grounded042/landerviz/hardware/carrier/shopping-digikey.csv

DigiKey Part Number | Quantity | Customer Reference
5032-333011-ND | 2 | J1 J2 USB-C breakout modules
102-1760-ND | 1 | SW3 12-detent encoder with push
CP1-3533NG-ND | 1 | J3 three-terminal audio jack
BAT85SCT-ND | 4 | D1 D2 D3 D4 audio clamps - cut tape
BC1050CT-ND | 2 | C3 C5 2.2nF C0G 5mm lead spacing - cut tape
754-1915-ND | 1 | D5 green status LED
SW400-ND | 2 | SW1 SW2 boot and reset - omit if already owned and matching
