grounded042/landerviz/hardware/carrier/landerviz-carrier.kicad_pcb

## KiCad design hardware/carrier/landerviz-carrier.kicad_pcb (2026-11-08)

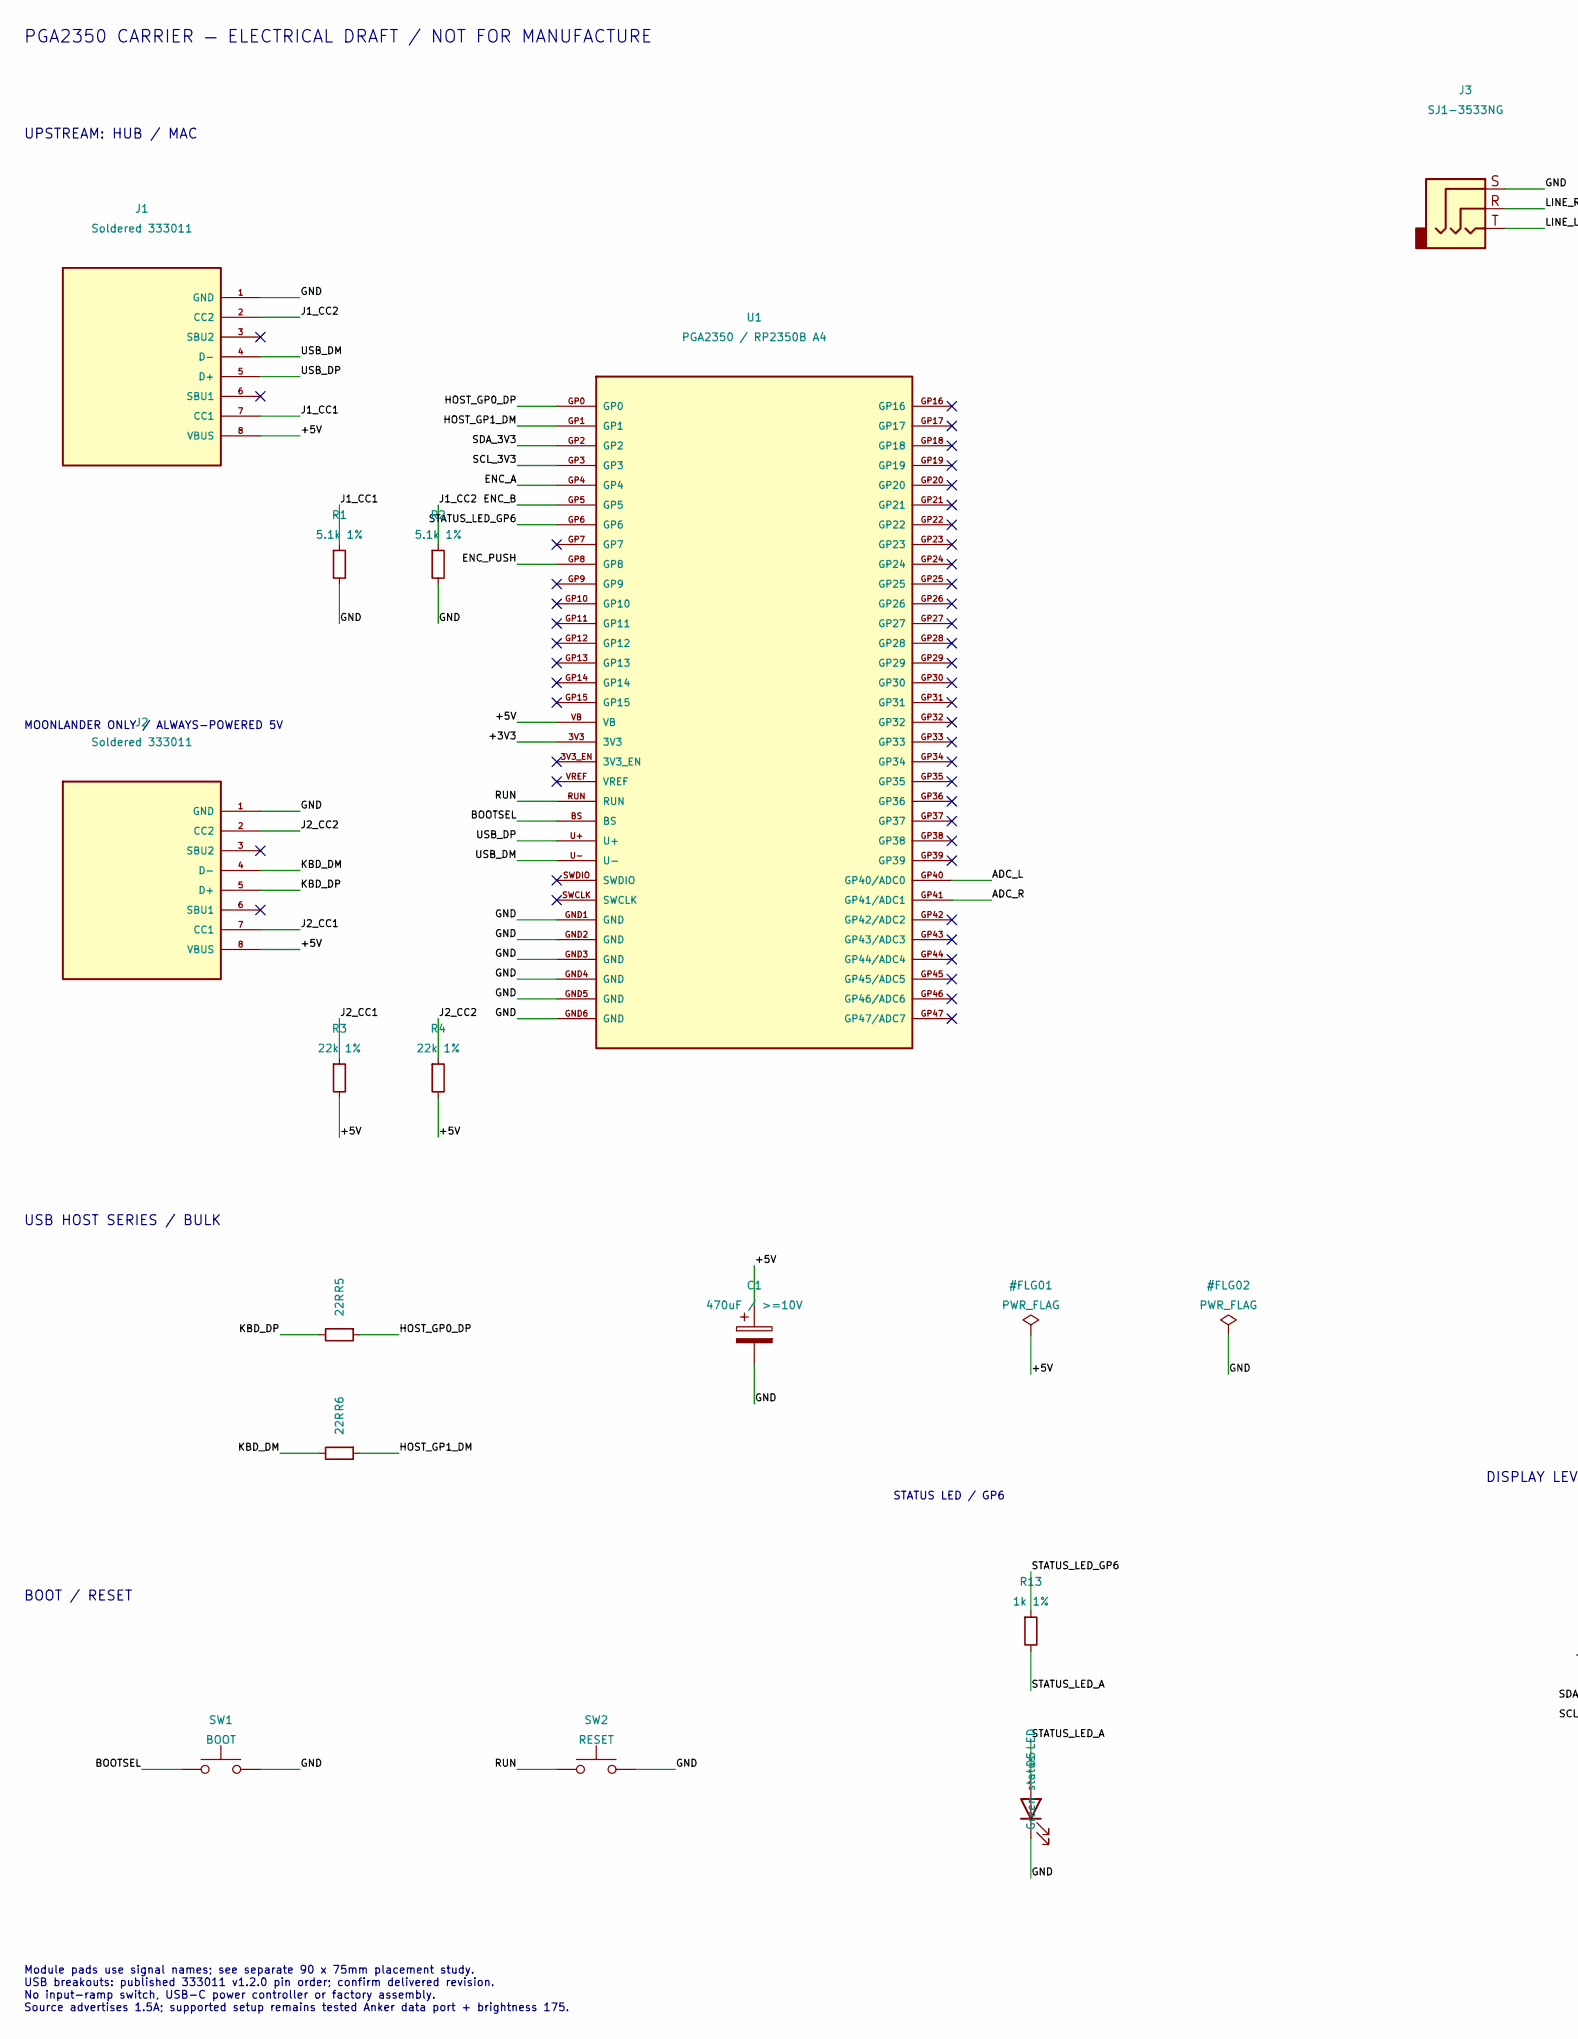
[picture p1: schematic landerviz-carrier.kicad_sch, LanderViz PGA2350 carrier — electrical draft, part in row 1, column 1]

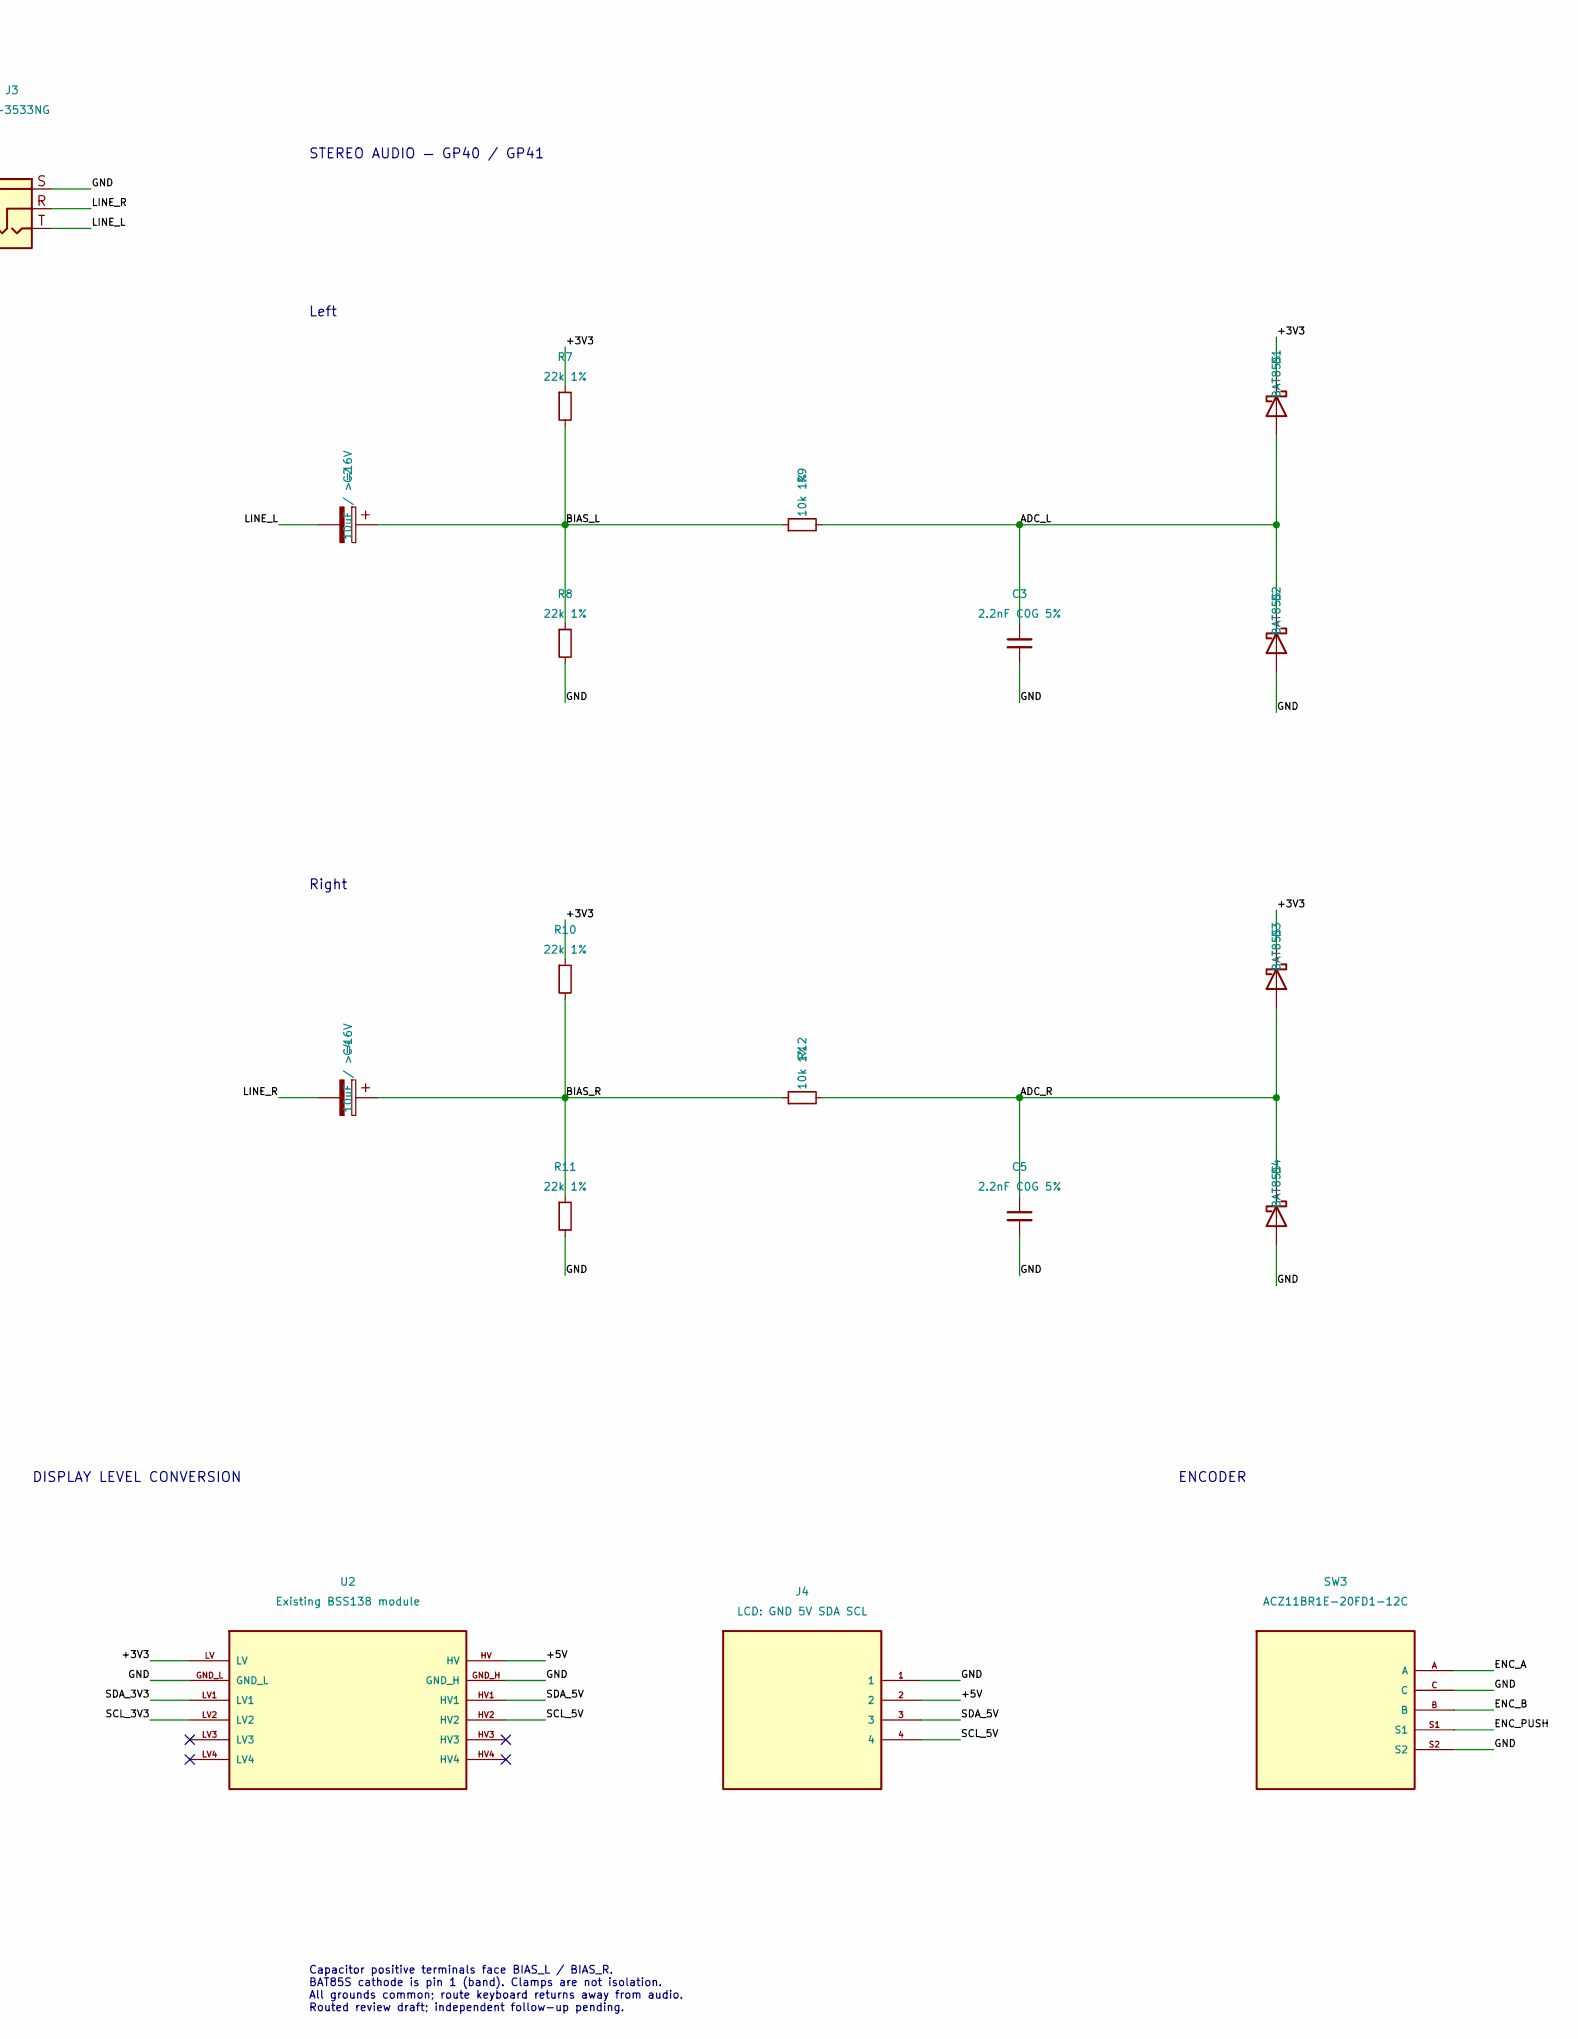
[picture p2: schematic landerviz-carrier.kicad_sch, LanderViz PGA2350 carrier — electrical draft, part in row 1, column 2]

Parts:
C1: 470uF / >=10V; CP_Radial_D8.0mm_P3.50mm
C2, C4: 10uF / >=16V; CP_Radial_D6.3mm_P2.50mm
C3, C5: 2.2nF C0G 5%; C_Disc_D5.0mm_W2.5mm_P5.00mm
D1, D2, D3, D4: BAT85S; D_DO-35_SOD27_P7.62mm_Horizontal; MPN BAT85S-TR
D5: Green status LED; LED_D3.0mm; MPN WP710A10LZGCK
J1, J2: Soldered 333011; Soldered_333011; MPN 333011
J3: SJ1-3533NG; Jack_3.5mm_CUI_SJ1-3533NG_Horizontal_CircularHoles; MPN SJ1-3533NG
J4: LCD: GND 5V SDA SCL; PinHeader_1x04_P2.54mm_Vertical
R1, R2: 5.1k 1%; R_Axial_DIN0207_L6.3mm_D2.5mm_P7.62mm_Horizontal
R3, R4, R7, R8, R10, R11: 22k 1%; R_Axial_DIN0207_L6.3mm_D2.5mm_P7.62mm_Horizontal
R5, R6: 22R; R_Axial_DIN0207_L6.3mm_D2.5mm_P7.62mm_Horizontal
R9, R12: 10k 1%; R_Axial_DIN0207_L6.3mm_D2.5mm_P7.62mm_Horizontal
R13: 1k 1%; R_Axial_DIN0207_L6.3mm_D2.5mm_P7.62mm_Horizontal
SW1: BOOT; SW_PUSH_6mm
SW2: RESET; SW_PUSH_6mm
SW3: ACZ11BR1E-20FD1-12C; Encoder_SameSky_ACZ11BR1E_Vertical; MPN ACZ11BR1E-20FD1-12C
U1: PGA2350 / RP2350B A4; PGA2350_Socket_Grid; MPN PIM722
U2: Existing BSS138 module; Level_Converter_PROVISIONAL

Connections:
/+3V3: D1.1 (K), D3.1 (K), R7.1, R10.1, U1.3V3, U2.LV
/+5V: C1.1, J1.8 (VBUS), J2.8 (VBUS), J4.2, R3.2, R4.2, U1.VB, U2.HV
/ADC_L: C3.1, D1.2 (A), D2.1 (K), R9.2, U1.GP40 (GP40/ADC0)
/ADC_R: C5.1, D3.2 (A), D4.1 (K), R12.2, U1.GP41 (GP41/ADC1)
/BIAS_L: C2.1, R7.2, R8.1, R9.1
/BIAS_R: C4.1, R10.2, R11.1, R12.1
/BOOTSEL: SW1.1, U1.BS
/ENC_A: SW3.A, U1.GP4
/ENC_B: SW3.B, U1.GP5
/ENC_PUSH: SW3.S1, U1.GP8
/GND: C1.2, C3.2, C5.2, D2.2 (A), D4.2 (A), D5.1 (K), J1.1 (GND), J2.1 (GND), J3.S, J4.1, R1.2, R2.2, R8.2, R11.2, SW1.2, SW2.2, SW3.C, SW3.S2, U1.GND1 (GND), U1.GND2 (GND), U1.GND3 (GND), U1.GND4 (GND), U1.GND5 (GND), U1.GND6 (GND), U2.GND_H, U2.GND_L
/HOST_GP0_DP: R5.1, U1.GP0
/HOST_GP1_DM: R6.1, U1.GP1
/J1_CC1: J1.7 (CC1), R1.1
/J1_CC2: J1.2 (CC2), R2.1
/J2_CC1: J2.7 (CC1), R3.1
/J2_CC2: J2.2 (CC2), R4.1
/KBD_DM: J2.4 (D-), R6.2
/KBD_DP: J2.5 (D+), R5.2
/LINE_L: C2.2, J3.T
/LINE_R: C4.2, J3.R
/RUN: SW2.1, U1.RUN
/SCL_3V3: U1.GP3, U2.LV2
/SCL_5V: J4.4, U2.HV2
/SDA_3V3: U1.GP2, U2.LV1
/SDA_5V: J4.3, U2.HV1
/STATUS_LED_A: D5.2 (A), R13.2
/STATUS_LED_GP6: R13.1, U1.GP6
/USB_DM: J1.4 (D-), U1.U-
/USB_DP: J1.5 (D+), U1.U+

Notes on the sheet:
PGA2350 CARRIER — ELECTRICAL DRAFT / NOT FOR MANUFACTURE
UPSTREAM: HUB / MAC
MOONLANDER ONLY / ALWAYS-POWERED 5V
STEREO AUDIO — GP40 / GP41
Left
Right
USB HOST SERIES / BULK
BOOT / RESET
DISPLAY LEVEL CONVERSION
ENCODER
STATUS LED / GP6
Module pads use signal names; see separate 90 x 75mm placement study. USB breakouts: published 333011 v1.2.0 pin order; confirm delivered revision. No input-ramp switch, USB-C power controller or factory assembly. Source advertises 1.5A; supported setup remains tested Anker data port + brightness 1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
Capacitor positive terminals face BIAS_L / BIAS_R. BAT85S cathode is pin 1 (band). Clamps are not isolation. All grounds common; route keyboard returns away from audio. Routed review draft; independent follow-up pending.

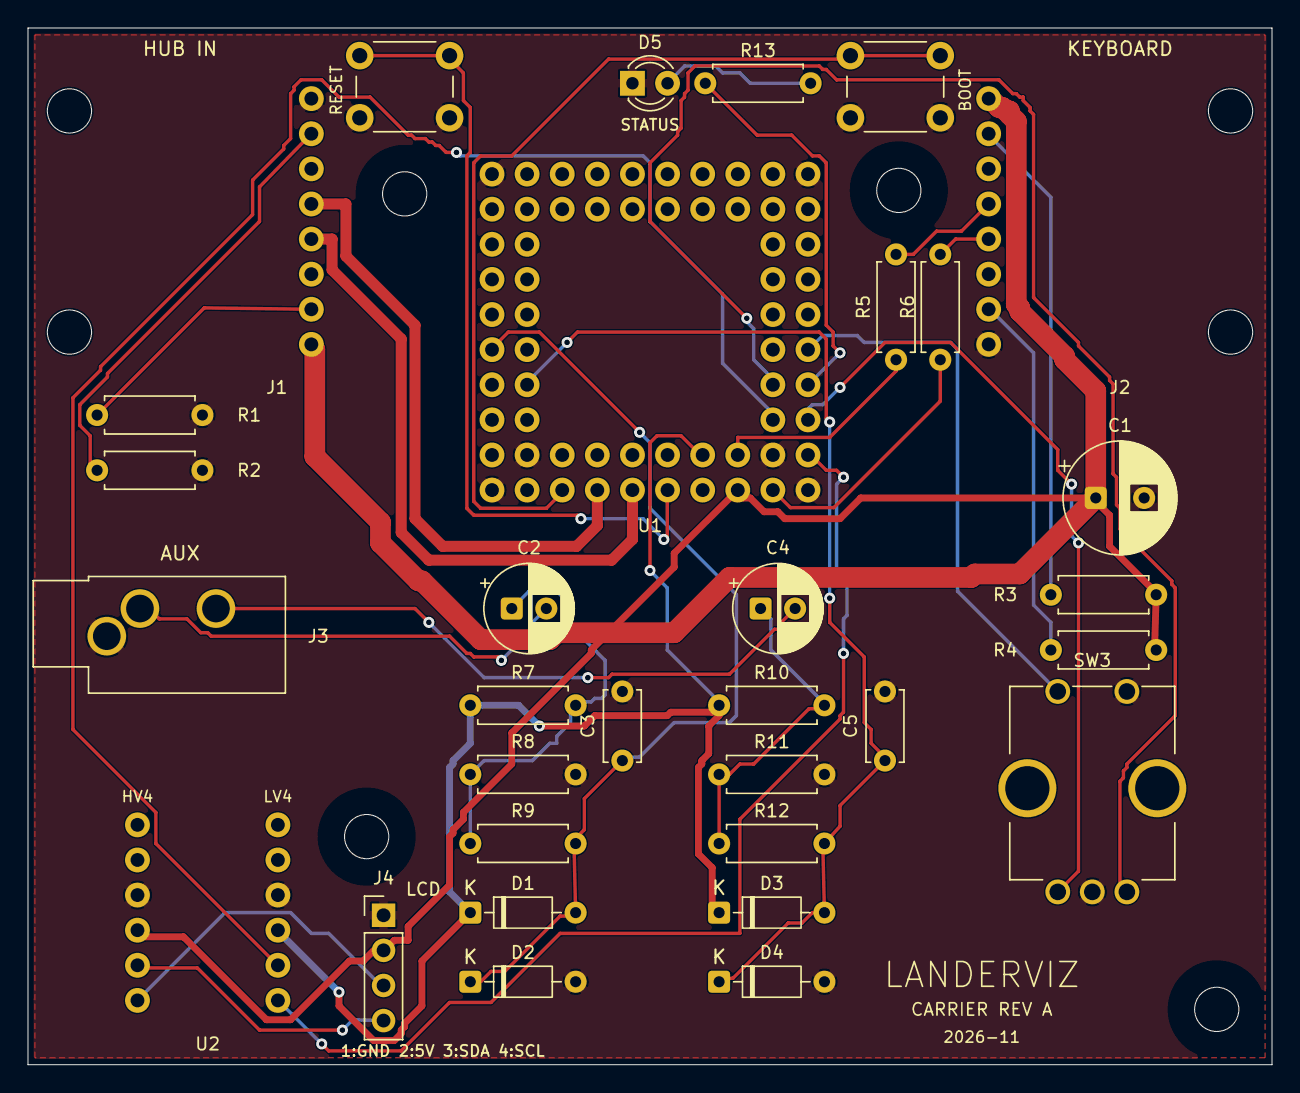
[picture p3: board landerviz-carrier.kicad_pcb from above]

Board: 2 copper layers, 90.0 x 75.0 mm, 36 parts (0 on the bottom side), 30 nets.

Other parts of the board:
H1, H2, H3, H4: M3 / max OD 7mm; MountingHole_3.2mm_M3_7mmHardware
