grounded042/landerviz/hardware/landerviz.kicad_pcb

## KiCad design hardware/landerviz.kicad_pcb (2026-11-07)

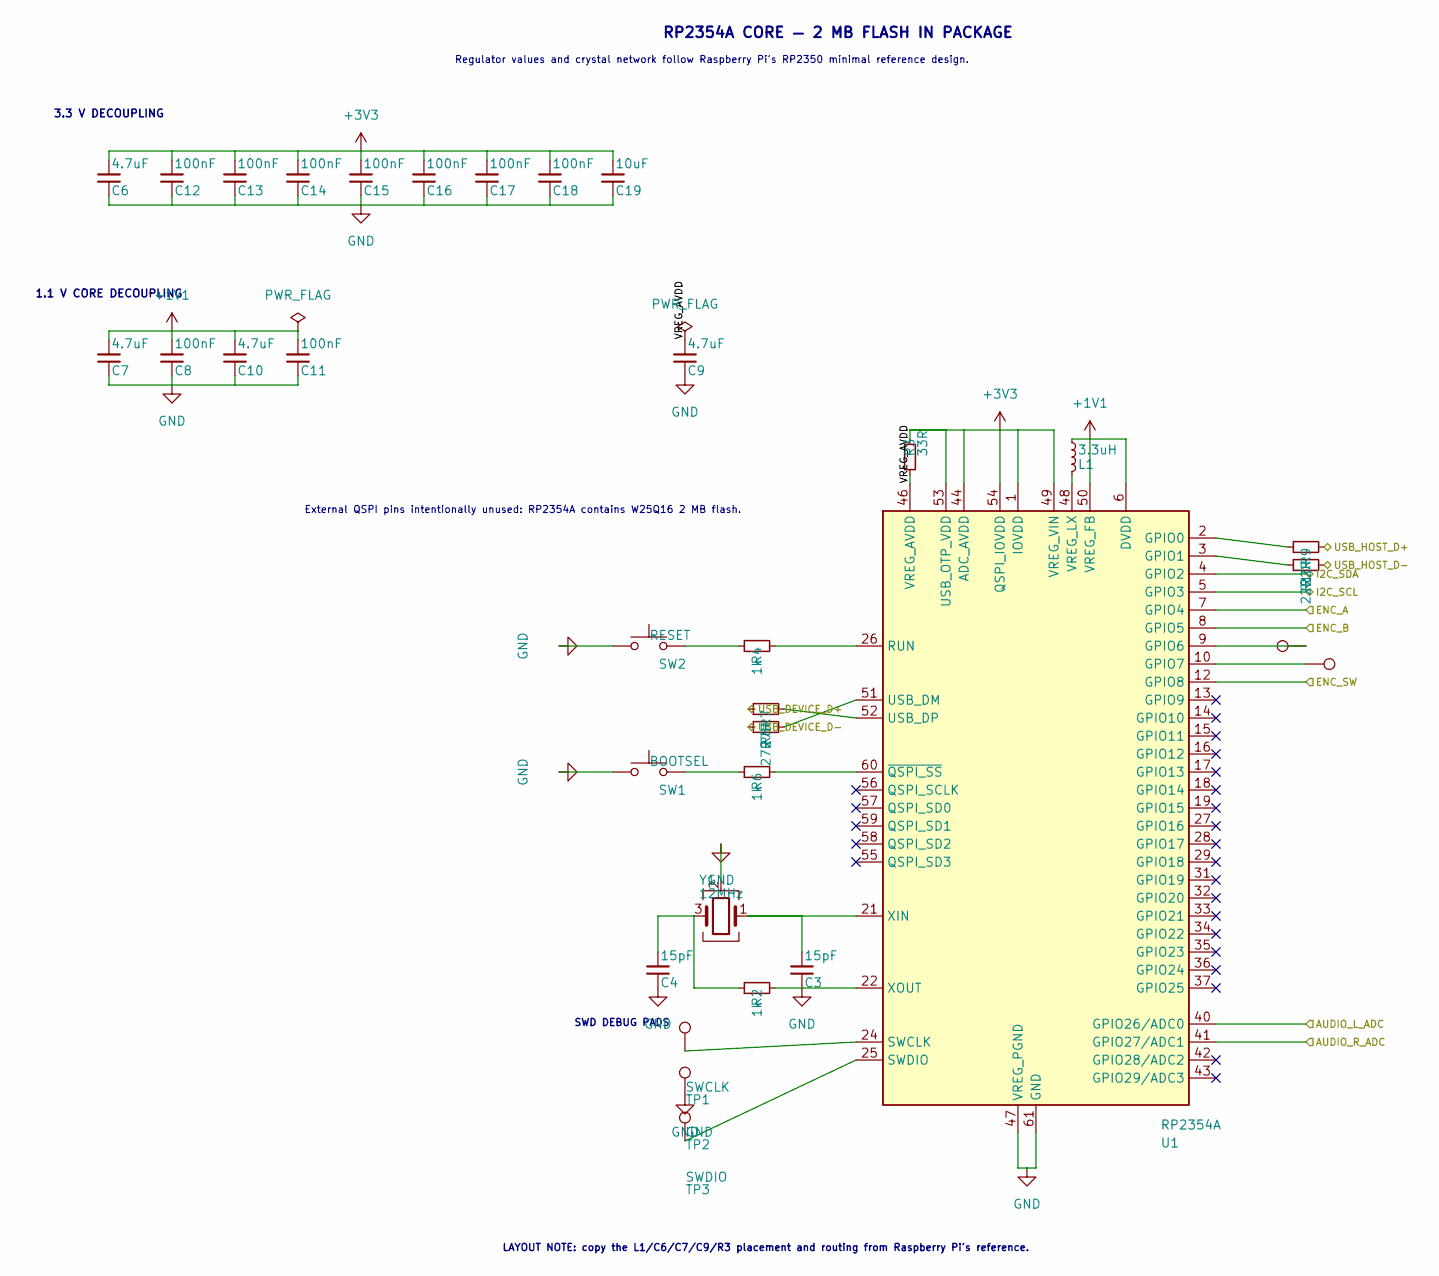
[picture p4: schematic mcu.kicad_sch]

Parts:
C3, C4: 15pF; C_0402_1005Metric; MPN 0402CG150J500NT; LCSC C1548
C6, C7, C9, C10: 4.7uF; C_0402_1005Metric; MPN GRM155R60J475ME47D; LCSC C82453
C8, C11, C12, C13, C14, C15, C16, C17, C18: 100nF; C_0402_1005Metric; MPN CL05B104KO5NNNC; LCSC C1525
C19: 10uF; C_0402_1005Metric; MPN TCC0402X5R106M6R3ATR; LCSC C48543727
L1: 3.3uH; L_Abracon_AOTA-B201610S3R3-101-T; MPN AOTA-B201610S3R3-101-T; LCSC C42411119
R2, R4, R6: 1k; R_0402_1005Metric; MPN 0402WGF1001TCE; LCSC C11702
R3: 33R; R_0402_1005Metric; MPN 0402WGF330JTCE; LCSC C25105
R7, R8: 27R; R_0402_1005Metric; MPN 0402WGF270JTCE; LCSC C25100
R9, R10: 22R; R_0402_1005Metric; MPN 0402WGF220JTCE; LCSC C25092
SW1: BOOTSEL; SW_Push_1P1T_XKB_TS-1187A; MPN TS-1187A-B-A-B; LCSC C318884
SW2: RESET; SW_Push_1P1T_XKB_TS-1187A; MPN TS-1187A-B-A-B; LCSC C318884
TP1: SWCLK; TestPoint_Pad_D2.0mm
TP2: GND; TestPoint_Pad_D2.0mm
TP3: SWDIO; TestPoint_Pad_D2.0mm
TP11: GPIO6; TestPoint_Pad_D2.0mm
TP12: GPIO7; TestPoint_Pad_D2.0mm
U1: RP2354A; QFN-60-1EP_7x7mm_P0.4mm_EP3.4x3.4mm_LanderViz; MPN RP2354A; LCSC C41378174
Y1: 12MHz; Crystal_SMD_3225-4Pin_3.2x2.5mm; MPN ABM8-272-T3; LCSC C20625731

Connections:
+1V1: C7.1, C8.1, C10.1, C11.1, L1.1, U1.6 (DVDD), U1.23 (DVDD), U1.39 (DVDD), U1.50 (VREG_FB)
+3V3: C6.1, C12.1, C13.1, C14.1, C15.1, C16.1, C17.1, C18.1, C19.1, R3.1, U1.1 (IOVDD), U1.11 (IOVDD), U1.20 (IOVDD), U1.30 (IOVDD), U1.38 (IOVDD), U1.44 (ADC_AVDD), U1.45 (IOVDD), U1.49 (VREG_VIN), U1.53 (USB_OTP_VDD), U1.54 (QSPI_IOVDD); also elsewhere on the board
/Audio frontend/AUDIO_L_ADC: U1.40 (GPIO26/ADC0); also elsewhere on the board
/Audio frontend/AUDIO_R_ADC: U1.41 (GPIO27/ADC1); also elsewhere on the board
/ENC_A: U1.7 (GPIO4); also elsewhere on the board
/ENC_B: U1.8 (GPIO5); also elsewhere on the board
/ENC_SW: U1.12 (GPIO8); also elsewhere on the board
/I2C_SCL: U1.5 (GPIO3); also elsewhere on the board
/I2C_SDA: U1.4 (GPIO2); also elsewhere on the board
/MCU core/VREG_AVDD: C9.1, R3.2, U1.46 (VREG_AVDD)
/USB and power/USB_DEVICE_D+: R7.1; also elsewhere on the board
/USB and power/USB_DEVICE_D-: R8.1; also elsewhere on the board
/USB and power/USB_HOST_D+: R9.2; also elsewhere on the board
/USB and power/USB_HOST_D-: R10.2; also elsewhere on the board
unnamed: C4.1, R2.1, Y1.3
unnamed: R4.1, SW2.2
unnamed: R6.1, SW1.2
unnamed: R9.1, U1.2 (GPIO0)
unnamed: R10.1, U1.3 (GPIO1)
unnamed: TP11.1, U1.9 (GPIO6)
unnamed: TP12.1, U1.10 (GPIO7)
unnamed: R4.2, U1.26 (RUN)
unnamed: TP1.1, U1.24 (SWCLK)
unnamed: TP3.1, U1.25 (SWDIO)
unnamed: R8.2, U1.51 (USB_DM)
unnamed: R7.2, U1.52 (USB_DP)
unnamed: L1.2, U1.48 (VREG_LX)
unnamed: C3.1, U1.21 (XIN), Y1.1
unnamed: R6.2, U1.60 (~QSPI_SS)

Notes on the sheet:
RP2354A CORE — 2 MB FLASH IN PACKAGE
Regulator values and crystal network follow Raspberry Pi's RP2350 minimal reference design.
3.3 V DECOUPLING
1.1 V CORE DECOUPLING
SWD DEBUG PADS
External QSPI pins intentionally unused: RP2354A contains W25Q16 2 MB flash.
LAYOUT NOTE: copy the L1/C6/C7/C9/R3 placement and routing from Raspberry Pi's reference.

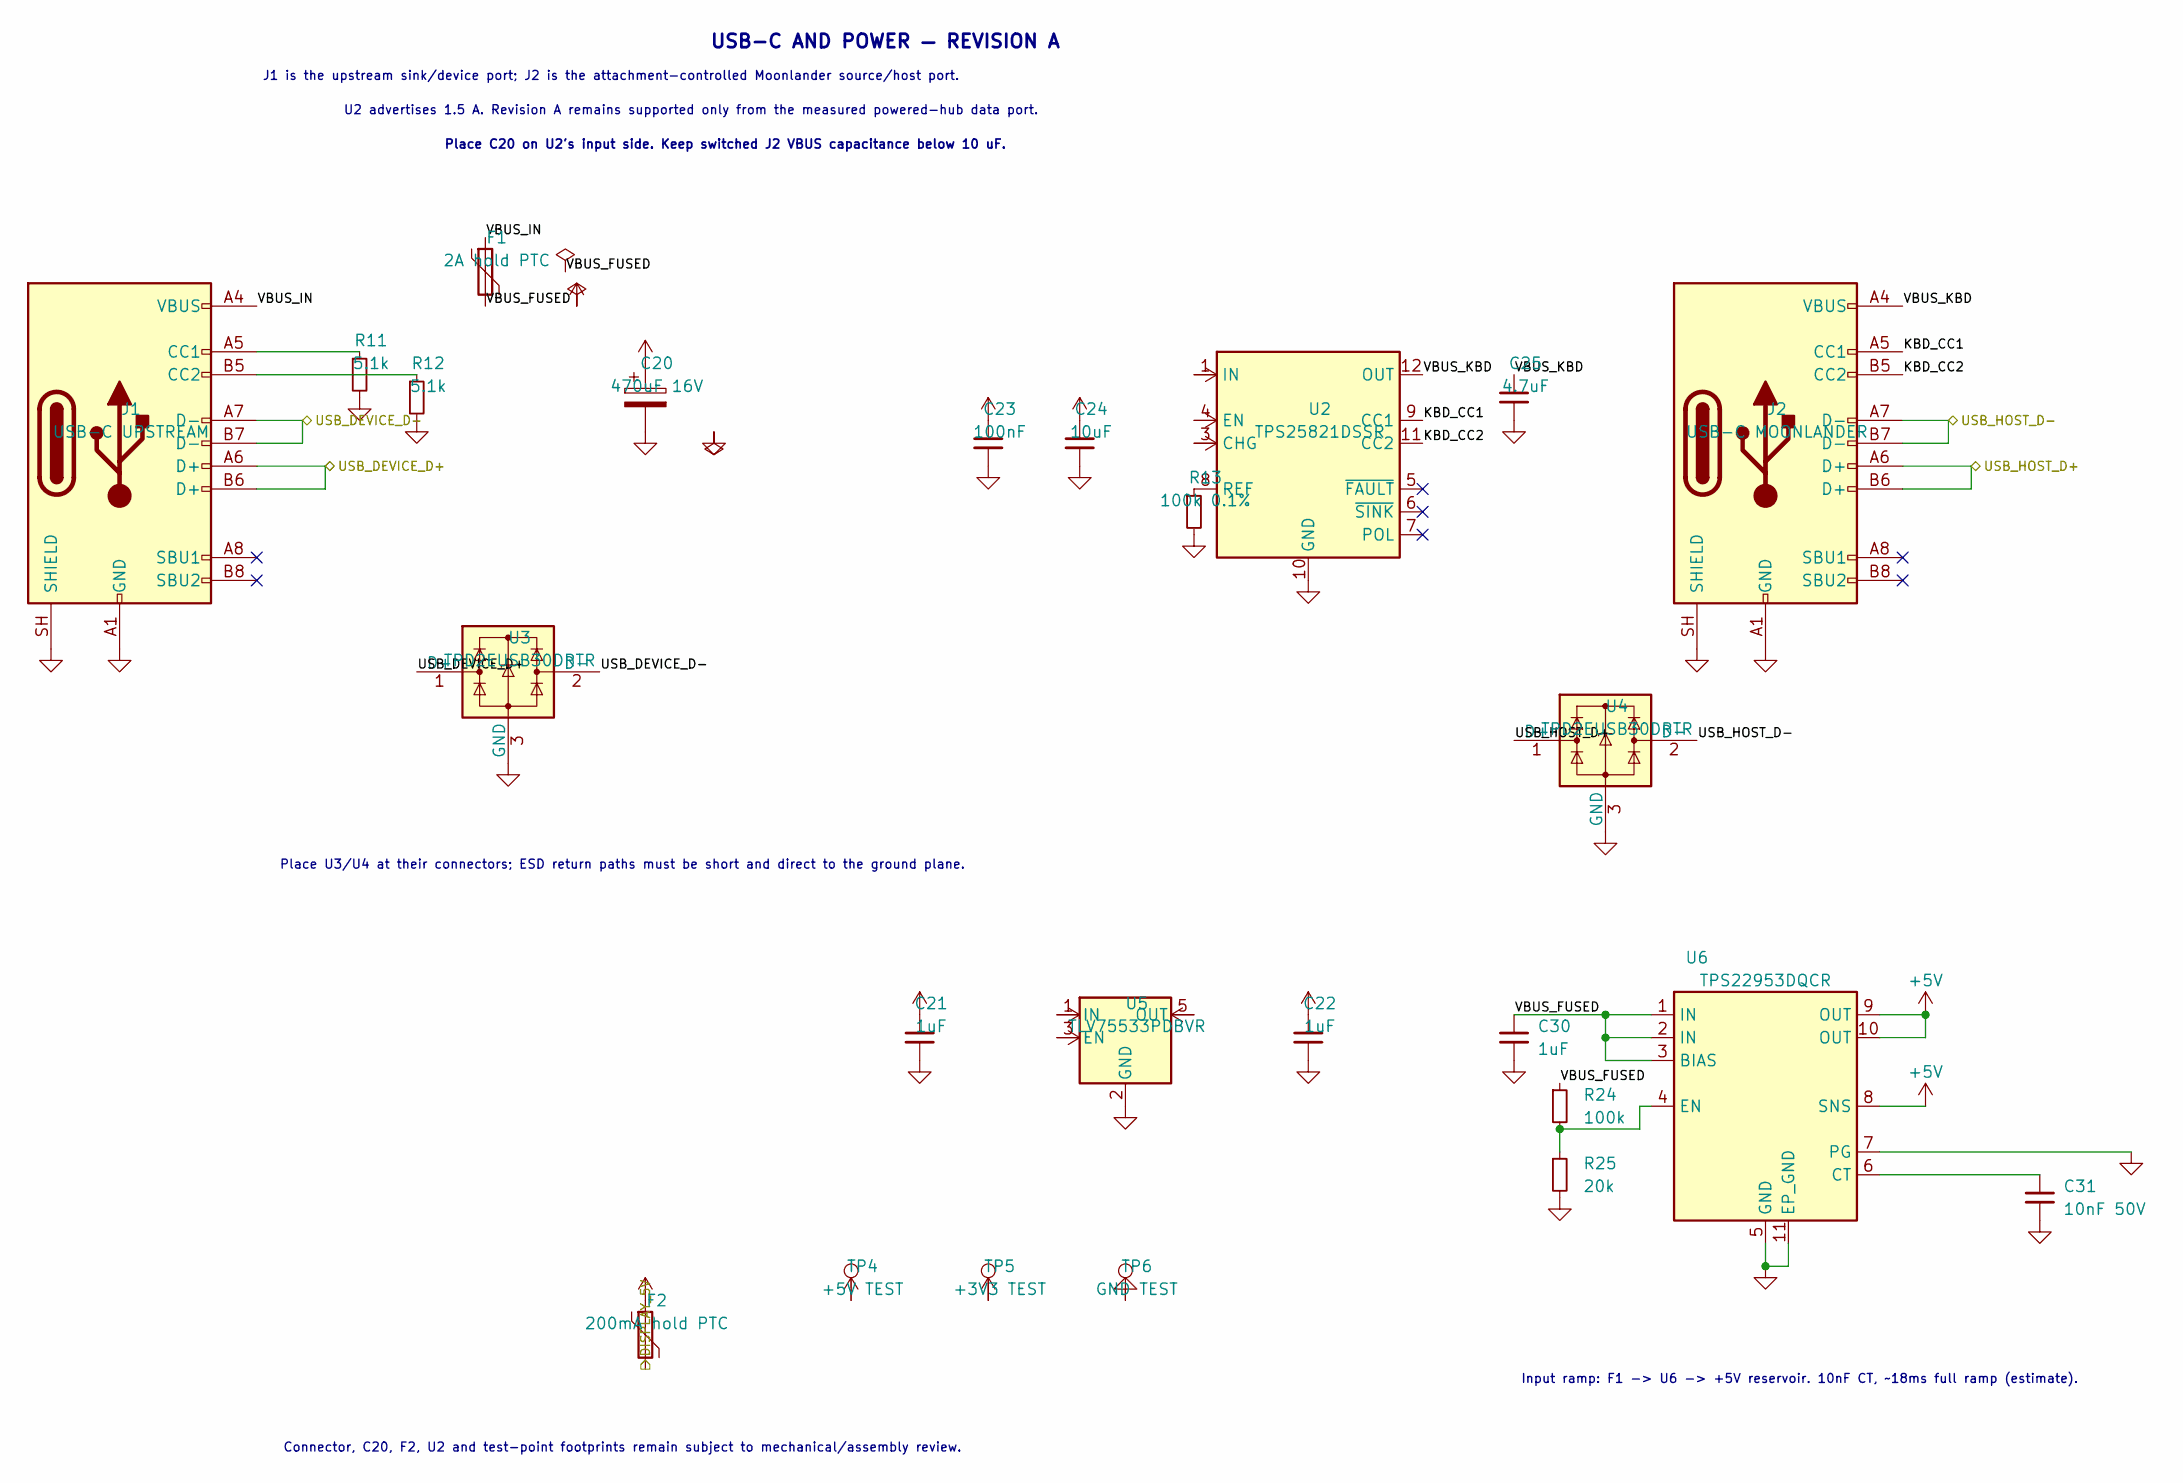
[picture p5: schematic usb_power.kicad_sch]

Parts:
C20: 470uF 16V; CP_Elec_8x10.5; MPN RVT1C471M0810; LCSC C3341
C21, C22, C30: 1uF; C_0603_1608Metric; MPN CL10A105KA8NNNC; LCSC C5673
C23: 100nF; C_0402_1005Metric; MPN CL05B104KO5NNNC; LCSC C1525
C24: 10uF; C_0805_2012Metric; MPN TCC0805X7R106K160FT; LCSC C380347
C25: 4.7uF; C_0603_1608Metric; MPN CL10Y475KP96PNC; LCSC C22371067
C31: 10nF 50V; C_0402_1005Metric; MPN CL05B103KB5NNNC; LCSC C15195
F1: 2A hold PTC; Fuse_1206_3216Metric; MPN 1206L200/16NR; LCSC C22374899
F2: 200mA hold PTC; Fuse_0603_1608Metric; MPN 0603L020YR; LCSC C207011
J1: USB-C UPSTREAM; USB_C_GCT_USB4105_LanderViz; MPN USB4105-GF-A-060; LCSC C3025063
J2: USB-C MOONLANDER; USB_C_GCT_USB4105_LanderViz; MPN USB4105-GF-A-060; LCSC C3025063
R11, R12: 5.1k; R_0402_1005Metric; MPN 0402WGF5101TCE; LCSC C25905
R13: 100k 0.1%; R_0402_1005Metric; MPN RT0402BRE07100KL; LCSC C136979
R24: 100k; R_0402_1005Metric; MPN 0402WGF1003TCE; LCSC C25741
R25: 20k; R_0402_1005Metric; MPN 0402WGF2002TCE; LCSC C25765
TP4: +5V TEST; TestPoint_Pad_D2.0mm
TP5: +3V3 TEST; TestPoint_Pad_D2.0mm
TP6: GND TEST; TestPoint_Pad_D2.0mm
U2: TPS25821DSSR; Texas_WSON-12-1EP_2x3mm_P0.5mm_DSS0012B; MPN TPS25821DSSR; LCSC C2861545
U3, U4: TPD2EUSB30DRTR; Texas_DRT-3; MPN TPD2EUSB30DRTR; LCSC C97502
U5: TLV75533PDBVR; SOT-23-5; MPN TLV75533PDBVR; LCSC C404027
U6: TPS22953DQCR; WSON-10-1EP_2x3mm_P0.5mm_EP0.84x2.4mm; MPN TPS22953DQCR; LCSC C471046

Connections:
+3V3: C22.1, TP5.1, U5.5 (OUT); also elsewhere on the board
+5V: C20.1, C21.1, C23.1, C24.1, F2.1, TP4.1, U2.1 (IN), U2.2 (IN), U2.3 (CHG), U2.4 (EN), U5.1 (IN), U5.3 (EN), U6.8 (SNS), U6.9 (OUT), U6.10 (OUT)
/DISPLAY_5V: F2.2; also elsewhere on the board
/USB and power/KBD_CC1: J2.A5 (CC1), U2.9 (CC1)
/USB and power/KBD_CC2: J2.B5 (CC2), U2.11 (CC2)
/USB and power/USB_DEVICE_D+: J1.A6 (D+), J1.B6 (D+), U3.1 (D+); also elsewhere on the board
/USB and power/USB_DEVICE_D-: J1.A7 (D-), J1.B7 (D-), U3.2 (D-); also elsewhere on the board
/USB and power/USB_HOST_D+: J2.A6 (D+), J2.B6 (D+), U4.1 (D+); also elsewhere on the board
/USB and power/USB_HOST_D-: J2.A7 (D-), J2.B7 (D-), U4.2 (D-); also elsewhere on the board
/USB and power/VBUS_FUSED: C30.1, F1.2, R24.1, U6.1 (IN), U6.2 (IN), U6.3 (BIAS)
/USB and power/VBUS_IN: F1.1, J1.A4 (VBUS), J1.A9 (VBUS), J1.B4 (VBUS), J1.B9 (VBUS)
/USB and power/VBUS_KBD: C25.1, J2.A4 (VBUS), J2.A9 (VBUS), J2.B4 (VBUS), J2.B9 (VBUS), U2.12 (OUT)
unnamed: J1.A5 (CC1), R11.1
unnamed: J1.B5 (CC2), R12.1
unnamed: R13.1, U2.8 (REF)
unnamed: C31.1, U6.6 (CT)
unnamed: R24.2, R25.1, U6.4 (EN)

Notes on the sheet:
USB-C AND POWER — REVISION A
J1 is the upstream sink/device port; J2 is the attachment-controlled Moonlander source/host port.
U2 advertises 1.5 A. Revision A remains supported only from the measured powered-hub data port.
Place C20 on U2's input side. Keep switched J2 VBUS capacitance below 10 uF.
Place U3/U4 at their connectors; ESD return paths must be short and direct to the ground plane.
Connector, C20, F2, U2 and test-point footprints remain subject to mechanical/assembly review.
Input ramp: F1 -> U6 -> +5V reservoir. 10nF CT, ~18ms full ramp (estimate).

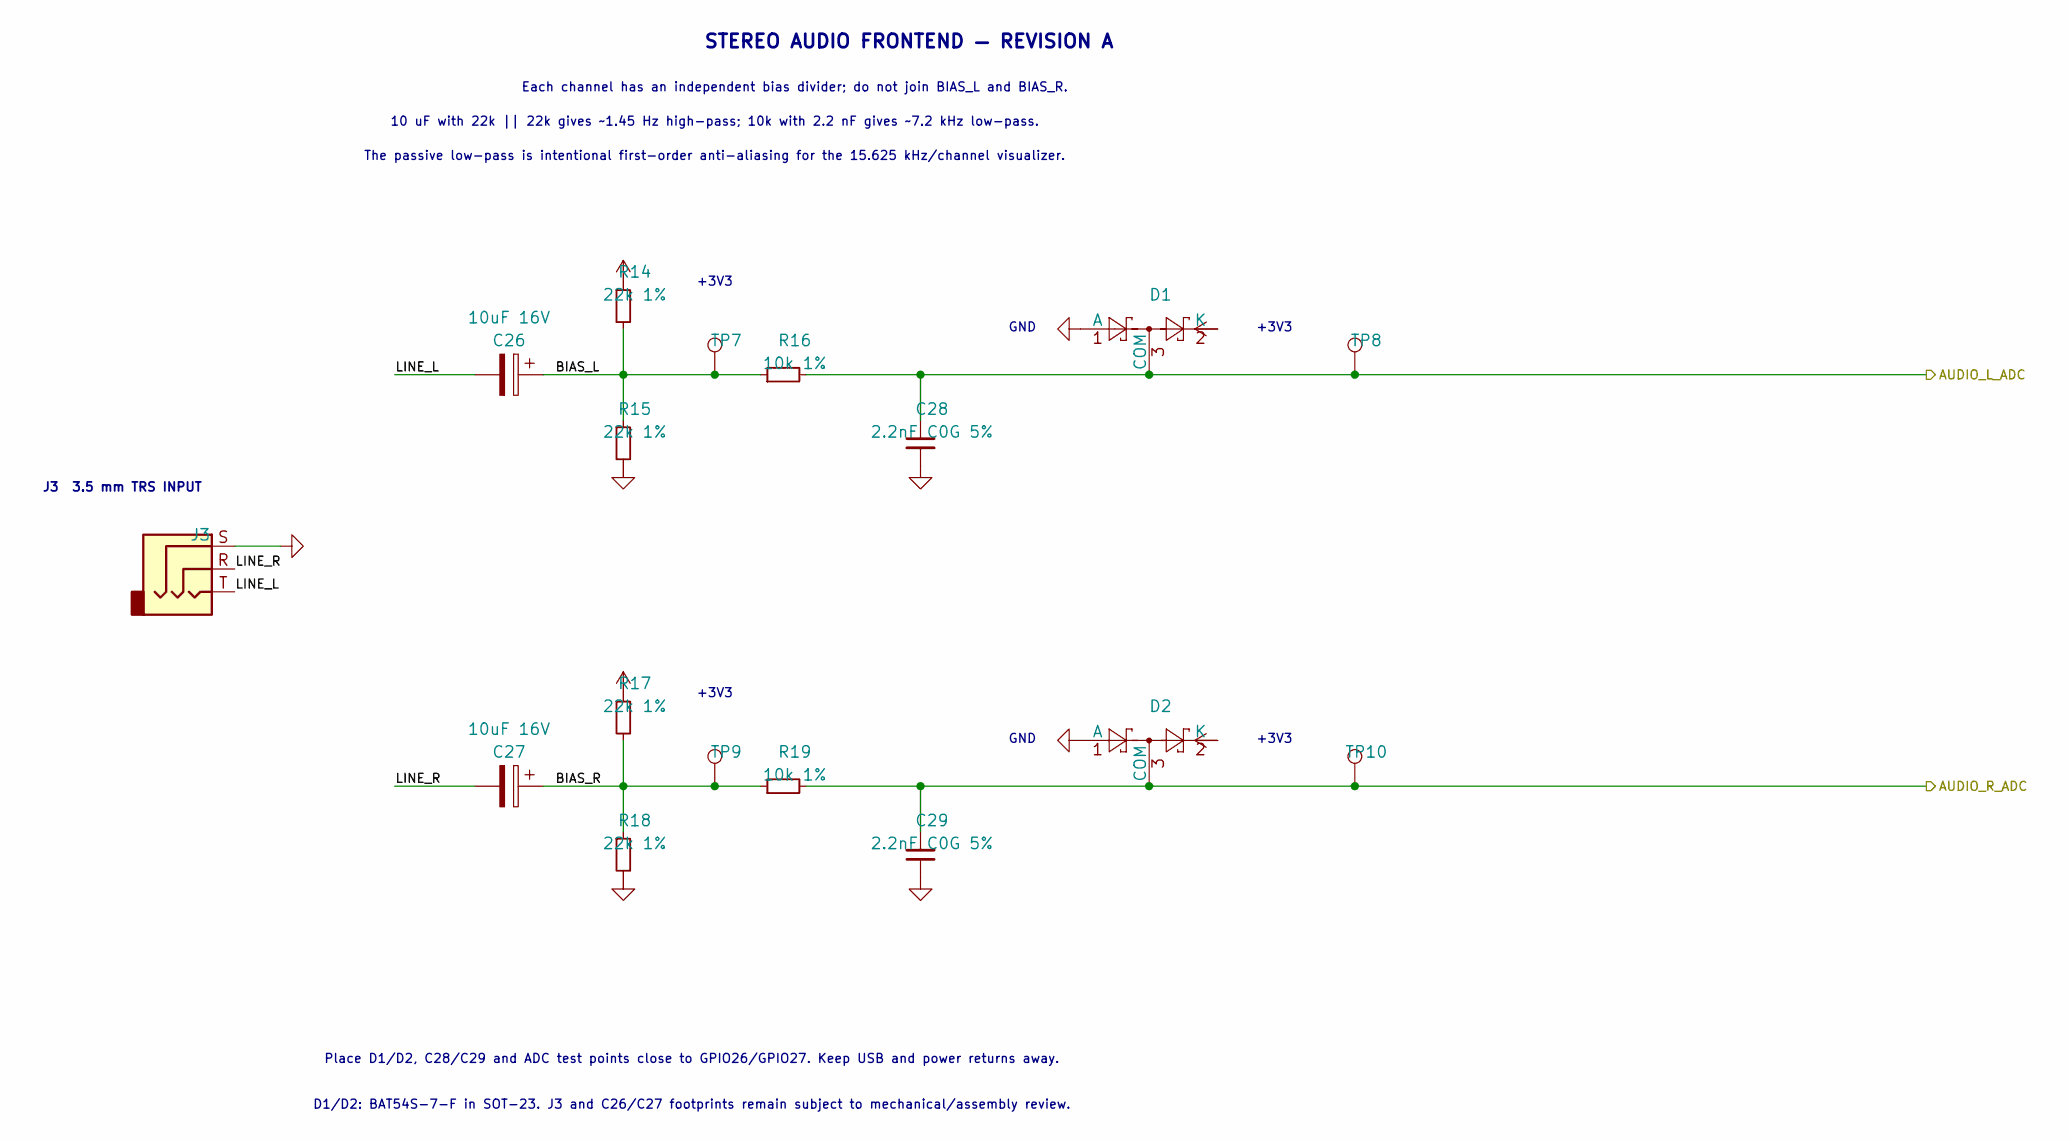
[picture p6: schematic audio.kicad_sch]

Parts:
C26, C27: 10uF 16V; CP_Elec_4x5.4; MPN RVT1C100M0405; LCSC C3357
C28, C29: 2.2nF C0G 5%; C_0402_1005Metric; MPN GRM1555C1H222JA01D; LCSC C385029
D1, D2: BAT54S-7-F; SOT-23; MPN BAT54S-7-F; LCSC C83574
J3: SJ1-3523N TRS INPUT; Jack_3.5mm_CUI_SJ1-3523N_Horizontal_LanderViz; MPN SJ1-3523N; LCSC C20182914
R14, R15, R17, R18: 22k 1%; R_0402_1005Metric; MPN 0402WGF2202TCE; LCSC C25768
R16, R19: 10k 1%; R_0402_1005Metric; MPN 0402WGF1002TCE; LCSC C25744
TP7: BIAS L TEST; TestPoint_Pad_D2.0mm
TP8: ADC L TEST; TestPoint_Pad_D2.0mm
TP9: BIAS R TEST; TestPoint_Pad_D2.0mm
TP10: ADC R TEST; TestPoint_Pad_D2.0mm

Connections:
+3V3: D1.2 (K), D2.2 (K), R14.1, R17.1; also elsewhere on the board
/Audio frontend/AUDIO_L_ADC: C28.1, D1.3 (COM), R16.2, TP8.1; also elsewhere on the board
/Audio frontend/AUDIO_R_ADC: C29.1, D2.3 (COM), R19.2, TP10.1; also elsewhere on the board
/Audio frontend/BIAS_L: C26.1, R14.2, R15.1, R16.1, TP7.1
/Audio frontend/BIAS_R: C27.1, R17.2, R18.1, R19.1, TP9.1
/Audio frontend/LINE_L: C26.2, J3.T
/Audio frontend/LINE_R: C27.2, J3.R

Notes on the sheet:
J3 3.5 mm TRS INPUT
+3V3
GND
STEREO AUDIO FRONTEND — REVISION A
Each channel has an independent bias divider; do not join BIAS_L and BIAS_R.
10 uF with 22k || 22k gives ~1.45 Hz high-pass; 10k with 2.2 nF gives ~7.2 kHz low-pass.
The passive low-pass is intentional first-order anti-aliasing for the 15.625 kHz/channel visualizer.
Place D1/D2, C28/C29 and ADC test points close to GPIO26/GPIO27. Keep USB and power returns away.
D1/D2: BAT54S-7-F in SOT-23. J3 and C26/C27 footprints remain subject to mechanical/assembly review.
