grounded042/landerviz/hardware/landerviz.kicad_pcb

## KiCad design hardware/landerviz.kicad_pcb (continued)

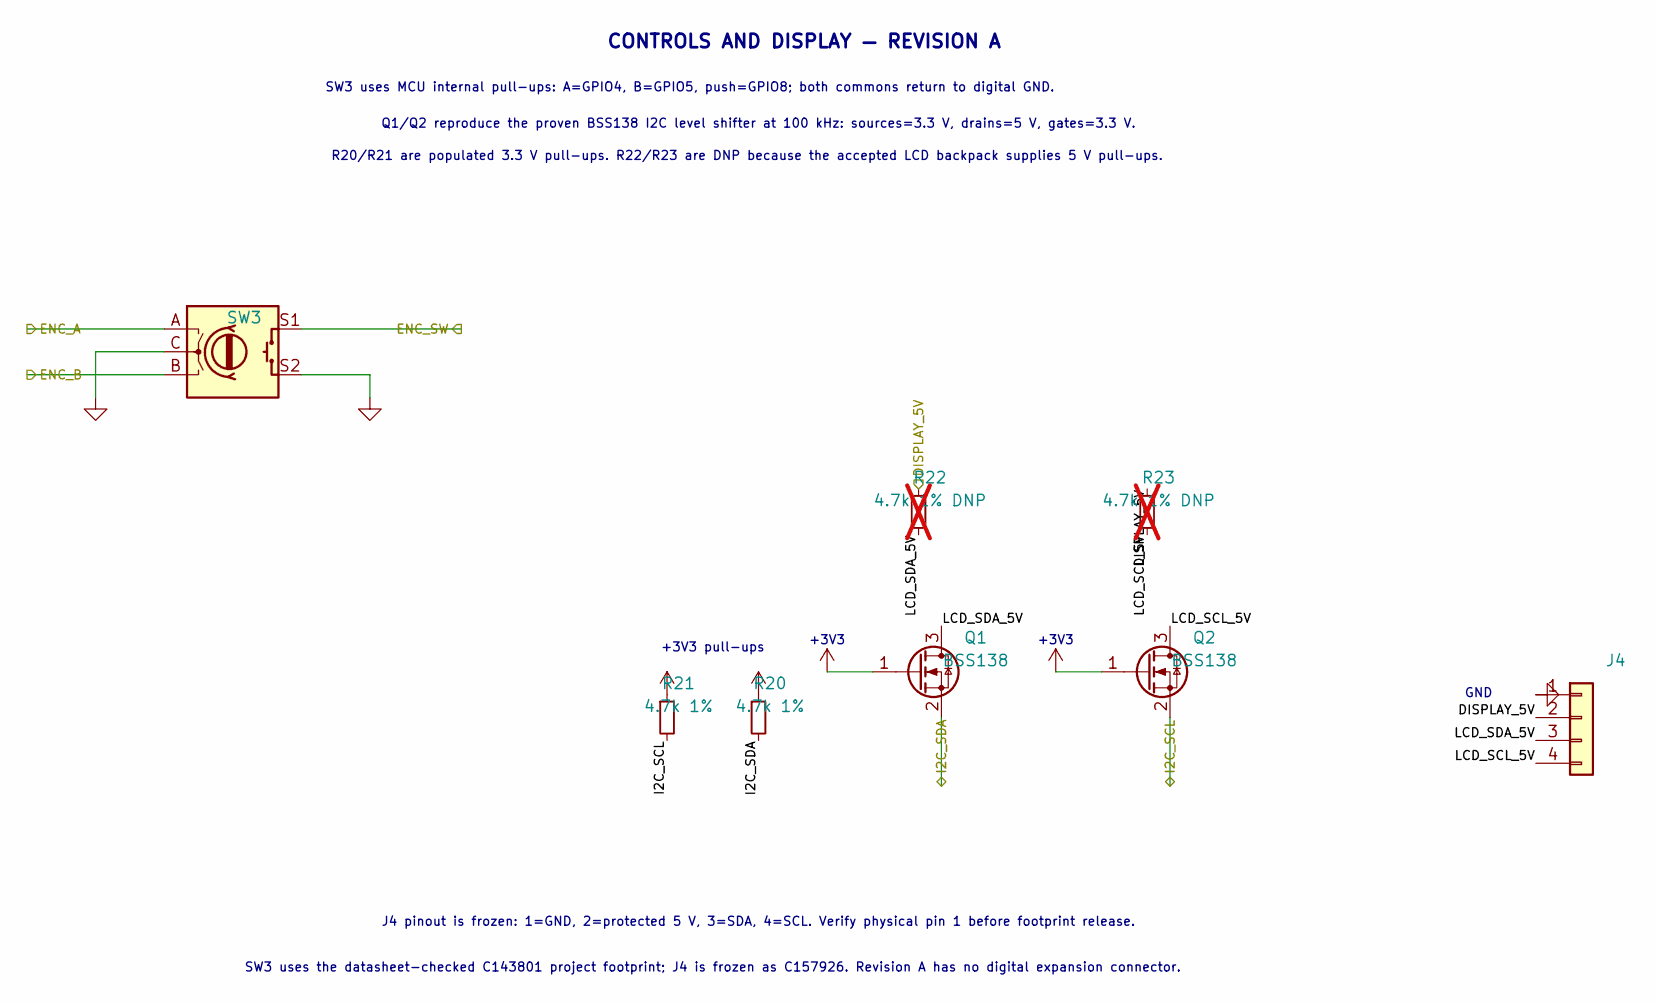
[picture p7: schematic controls_display.kicad_sch]

Parts:
J4: S4B-PH-K-S DISPLAY; JST_PH_S4B-PH-K_1x04_P2.00mm_Horizontal; MPN S4B-PH-K-S(LF)(SN); LCSC C157926
Q1, Q2: BSS138; SOT-23; MPN BSS138LT1G; LCSC C82045
R20, R21: 4.7k 1%; R_0402_1005Metric; MPN 0402WGF4701TCE; LCSC C25900
R22, R23: 4.7k 1% DNP; R_0402_1005Metric; MPN 0402WGF4701TCE; LCSC C25900; not fitted
SW3: PEC12R-4120F-S0012 12-detent encoder + push; RotaryEncoder_Bourns_Vertical_PEC12R-4x20F-Sxxxx; MPN PEC12R-4120F-S0012; LCSC C143801

Connections:
+3V3: Q1.1 (G), Q2.1 (G), R20.1, R21.1; also elsewhere on the board
/Controls and display/LCD_SCL_5V: J4.4, Q2.3 (D), R23.2
/Controls and display/LCD_SDA_5V: J4.3, Q1.3 (D), R22.2
/DISPLAY_5V: J4.2, R22.1, R23.1; also elsewhere on the board
/ENC_A: SW3.A; also elsewhere on the board
/ENC_B: SW3.B; also elsewhere on the board
/ENC_SW: SW3.S1; also elsewhere on the board
/I2C_SCL: Q2.2 (S), R21.2; also elsewhere on the board
/I2C_SDA: Q1.2 (S), R20.2; also elsewhere on the board

Notes on the sheet:
+3V3
+3V3 pull-ups
GND
CONTROLS AND DISPLAY — REVISION A
SW3 uses MCU internal pull-ups: A=GPIO4, B=GPIO5, push=GPIO8; both commons return to digital GND.
Q1/Q2 reproduce the proven BSS138 I2C level shifter at 100 kHz: sources=3.3 V, drains=5 V, gates=3.3 V.
R20/R21 are populated 3.3 V pull-ups. R22/R23 are DNP because the accepted LCD backpack supplies 5 V pull-ups.
J4 pinout is frozen: 1=GND, 2=protected 5 V, 3=SDA, 4=SCL. Verify physical pin 1 before footprint release.
SW3 uses the datasheet-checked C143801 project footprint; J4 is frozen as C157926. Revision A has no digital expansion connector.

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
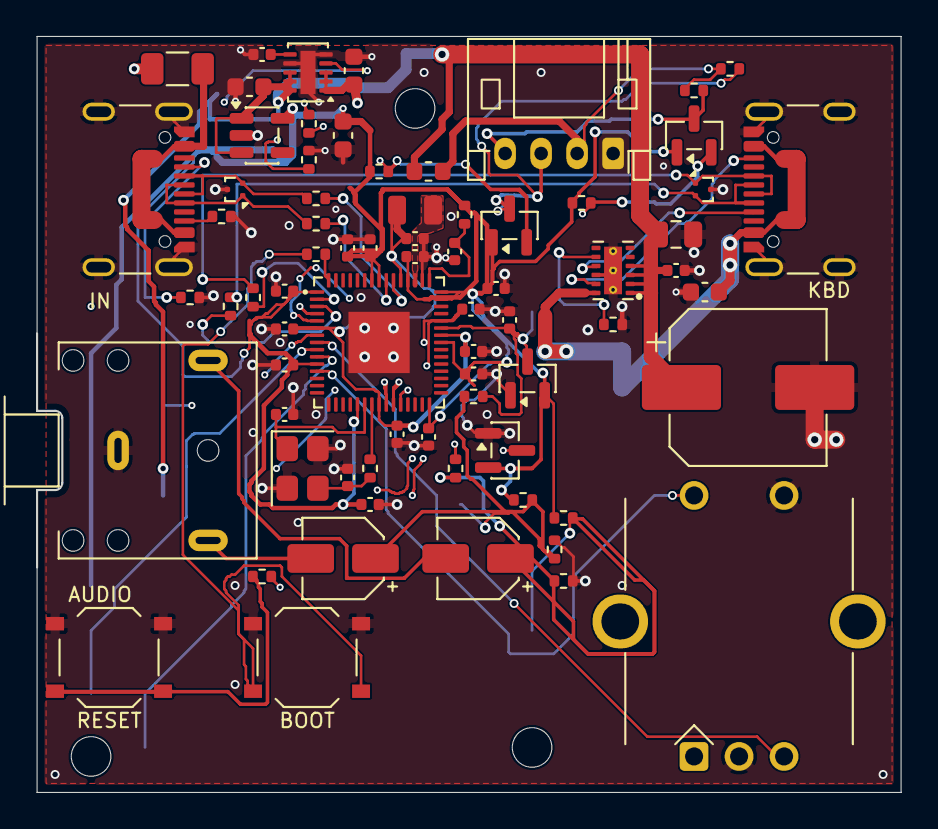
[picture p8: board landerviz.kicad_pcb from above]

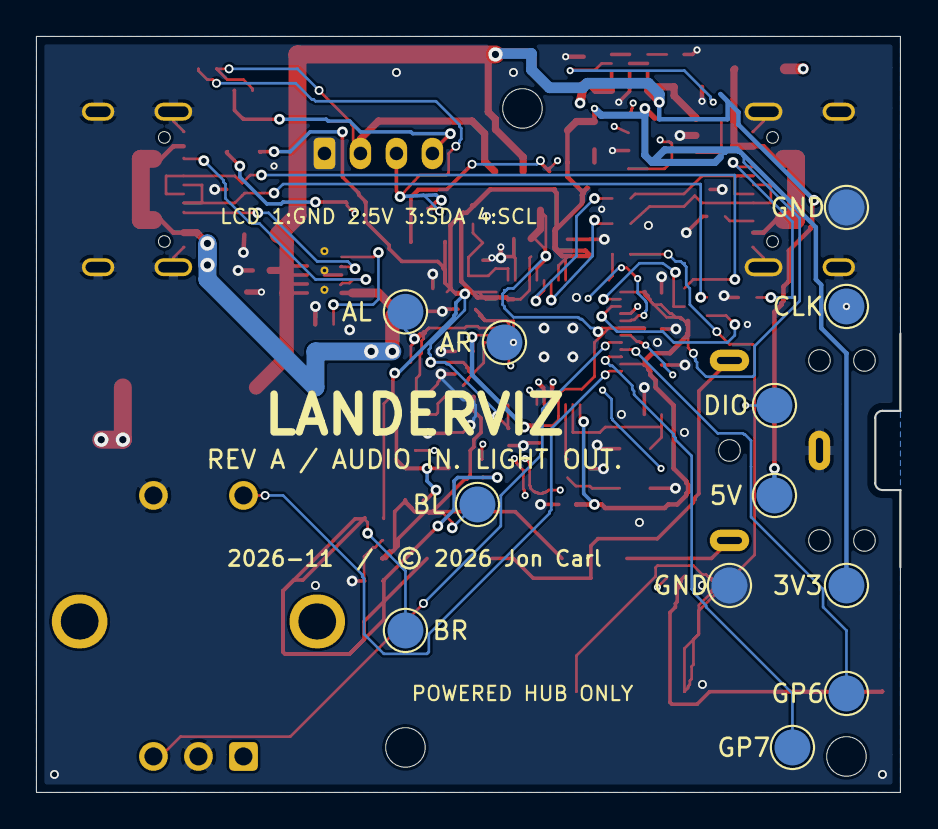
[picture p9: board landerviz.kicad_pcb from below]

Board: 4 copper layers, 48.0 x 42.0 mm, 87 parts (12 on the bottom side), 49 nets.

Other parts of the board:
H1, H2, H3: MountingHole_2.2mm_M2
