grounded042/landerviz/tusb_config.h

#pragma once

#define CFG_TUSB_MCU OPT_MCU_RP2040
#define CFG_TUSB_OS OPT_OS_PICO

#define CFG_TUD_ENABLED 1
#define CFG_TUH_ENABLED 1
#define CFG_TUH_RPI_PIO_USB 1

#define CFG_TUD_ENDPOINT0_SIZE 64
#define CFG_TUD_HID 1
#define CFG_TUD_HID_EP_BUFSIZE 64

#define CFG_TUH_ENUMERATION_BUFSIZE 512
#define CFG_TUH_HUB 0
#define CFG_TUH_DEVICE_MAX 1
#define CFG_TUH_HID 8
#define CFG_TUH_HID_EPIN_BUFSIZE 64
#define CFG_TUH_HID_EPOUT_BUFSIZE 64

#define CFG_TUSB_MEM_SECTION
#define CFG_TUSB_MEM_ALIGN __attribute__((aligned(4)))
