grounded042/landerviz/src/flow_v3_attack.cpp

#include "landerviz/flow_v3_attack.h"

#include <algorithm>
#include <cmath>
#include <cstring>

#include "landerviz/effects.h"
#include "landerviz/moonlander_map.h"

namespace {

constexpr float attack_fast_attack_ms = 25.0f;
constexpr float attack_fast_release_ms = 45.0f;
constexpr float attack_slow_attack_ms = 190.0f;
constexpr float attack_slow_release_ms = 300.0f;
constexpr float attack_log_scale = 15.0f;
constexpr float attack_reference = 0.28f;
constexpr float attack_lab_hue = 195.0f;
constexpr float attack_distance_fade = 0.975f;

float response(uint32_t elapsed_ms, float time_constant_ms) {
    return elapsed_ms > 0
               ? 1.0f - std::exp(-(float)elapsed_ms / time_constant_ms)
               : 1.0f;
}

float log_level(float level) {
    return std::log1p(attack_log_scale *
                      std::clamp(level, 0.0f, 1.0f)) /
           std::log1p(attack_log_scale);
}

float envelope(float current, float target, float attack_response,
               float release_response) {
    const float amount = target > current ? attack_response
                                          : release_response;
    return current + (target - current) * amount;
}

lv_flow_v3_slice_t blurred_sample(const lv_flow_v3_attack_t *state,
                                  float coordinate, uint32_t now_ms) {
    constexpr float offset = 0.22f;
    const auto before = lv_flow_v3_attack_sample(
        state, std::max(0.0f, coordinate - offset), now_ms);
    const auto center = lv_flow_v3_attack_sample(state, coordinate, now_ms);
    const auto after = lv_flow_v3_attack_sample(
        state, coordinate + offset, now_ms);
    lv_flow_v3_slice_t result = center;
    result.attack = before.attack * 0.25f + center.attack * 0.50f +
                    after.attack * 0.25f;
    return result;
}

lv_rgb_t render_sample(const lv_flow_v3_slice_t &sample, float coordinate) {
    const float attack = std::clamp(sample.attack, 0.0f, 1.0f);
    if (attack <= 0.001f) return {};
    const float distance_fade = std::pow(
        attack_distance_fade, std::max(0.0f, coordinate));
    const float value = (0.10f + 0.90f * attack) * distance_fade;
    return lv_hsv_to_rgb(
        (uint8_t)std::lround(attack_lab_hue * 255.0f / 360.0f), 255,
        (uint8_t)std::clamp(std::lround(value * 255.0f), 0l, 255l));
}

void set_key(lv_rgb_t frame[LV_KEY_COUNT], int key, lv_rgb_t color) {
    if (key >= 0 && key < LV_KEY_COUNT) frame[key] = color;
}

}  // namespace

void lv_flow_v3_attack_update(
    lv_flow_v3_attack_t *state,
    const lv_channel_analysis_t audio[LV_AUDIO_CHANNEL_COUNT],
    bool gate_open, uint32_t audio_time_ms) {
    const uint32_t elapsed_ms =
        state->initialized ? audio_time_ms - state->last_update_ms : 0;
    const float fast_attack_response = response(
        elapsed_ms, attack_fast_attack_ms);
    const float fast_release_response = response(
        elapsed_ms, attack_fast_release_ms);
    const float slow_attack_response = response(
        elapsed_ms, attack_slow_attack_ms);
    const float slow_release_response = response(
        elapsed_ms, attack_slow_release_ms);
    float squared_attack = 0.0f;
    for (int band = 0; band < LV_MEL_BAND_COUNT; ++band) {
        const float target = gate_open
                                 ? log_level(std::max(
                                       audio[0].mel_level[band],
                                       audio[1].mel_level[band]))
                                 : 0.0f;
        if (!state->initialized) {
            state->fast_level[band] = target;
            state->slow_level[band] = target;
        } else {
            state->fast_level[band] = envelope(
                state->fast_level[band], target,
                fast_attack_response, fast_release_response);
            state->slow_level[band] = envelope(
                state->slow_level[band], target,
                slow_attack_response, slow_release_response);
        }
        const float rise = std::max(
            0.0f, state->fast_level[band] - state->slow_level[band]);
        squared_attack += rise * rise;
    }
    const float raw_attack = std::sqrt(
        squared_attack / (float)LV_MEL_BAND_COUNT);
    const float attack = std::clamp(
        raw_attack / attack_reference, 0.0f, 1.0f);
    state->features = {
        raw_attack,
        attack,
        audio_time_ms,
        gate_open,
    };
    state->history[state->history_head] = {
        attack_lab_hue,
        255.0f,
        0.0f,
        0.0f,
        attack,
        0.0f,
        audio_time_ms,
    };
    state->history_head =
        (uint16_t)((state->history_head + 1) % LV_FLOW_V3_HISTORY);
    state->history_count =
        std::min<uint16_t>(state->history_count + 1, LV_FLOW_V3_HISTORY);
    state->last_update_ms = audio_time_ms;
    state->initialized = true;
}

void lv_flow_v3_attack_set_travel_ms(lv_flow_v3_attack_t *state,
                                     uint16_t travel_ms) {
    state->travel_ms = travel_ms > 0
                           ? std::clamp<uint16_t>(travel_ms, 50, 1000)
                           : (uint16_t)LV_FLOW_V3_DEFAULT_TRAVEL_MS;
}

lv_flow_v3_slice_t lv_flow_v3_attack_sample(
    const lv_flow_v3_attack_t *state, float coordinate, uint32_t now_ms) {
    const uint16_t travel_ms = state->travel_ms > 0
                                   ? state->travel_ms
                                   : (uint16_t)LV_FLOW_V3_DEFAULT_TRAVEL_MS;
    return lv_flow_v3_history_sample(
        state->history, state->history_head, state->history_count,
        travel_ms, coordinate, now_ms);
}

void lv_flow_v3_attack_render(const lv_flow_v3_attack_t *state,
                              uint32_t now_ms,
                              lv_rgb_t frame[LV_KEY_COUNT]) {
    std::memset(frame, 0, sizeof(lv_rgb_t) * LV_KEY_COUNT);
    for (int half = 0; half < LV_AUDIO_CHANNEL_COUNT; ++half) {
        for (int col = 0; col < LV_SPECTRAL_FLOW_COLUMNS; ++col) {
            const int distance = half == 0
                                     ? LV_SPECTRAL_FLOW_COLUMNS - 1 - col
                                     : col;
            for (int row = 0; row < 5; ++row) {
                const float coordinate = lv_spectral_flow_coordinate(
                    half, (float)distance, (float)row);
                set_key(frame, lv_key_at(half, col, row),
                        render_sample(blurred_sample(
                                          state, coordinate, now_ms),
                                      coordinate));
            }
        }
        for (int key = 0; key < 3; ++key) {
            const float coordinate = lv_spectral_flow_coordinate(
                half, 0.0f, (float)(key + 1));
            set_key(frame, lv_utility_key_at(half, key),
                    render_sample(blurred_sample(
                                      state, coordinate, now_ms),
                                  coordinate));
        }
        constexpr float thumb_distance[4] = {1.25f, 0.85f, 0.45f, 0.0f};
        for (int key = 0; key < 4; ++key) {
            const float coordinate = lv_spectral_flow_coordinate(
                half, thumb_distance[key], 3.2f + key * 0.2f);
            set_key(frame, lv_thumb_key_at(half, key),
                    render_sample(blurred_sample(
                                      state, coordinate, now_ms),
                                  coordinate));
        }
    }
}
