grounded042/landerviz/(commit log)

2026-10-16 Add smooth spectral flow visualization
2026-10-16 Document revision A PCB design basis
2026-10-17 rework flow to visualize more closely to the music
2026-10-17 feat(preview): freeze Flow v3 bass foundation
2026-10-17 feat(preview): add vivid midrange flow lab
2026-10-17 feat(preview): add capped energy floor to flow
2026-10-17 feat(preview): integrate high-frequency texture into flow v3
2026-10-18 feat(firmware): run flow v3 in real time
2026-10-18 docs: record flow v3 hardware acceptance
2026-10-18 docs: freeze revision-a PCB architecture
2026-10-21 feat: calibrate audio input and preserve quiet passages
2026-10-23 initial power test
2026-10-23 feat: migrate status LCD to I2C backpack
2026-10-23 feat: add rotary encoder hardware support
2026-10-29 feat: capture MCU and USB power schematics
2026-11-04 Prepare four-layer PCB for independent review
2026-11-07 fix(hardware): preserve reviewed bare-chip design and handoffs
    Correct regulator layout and component selection, add the approved input ramp, and retain review resolutions for the unbuilt bare-chip candidate.
    Add checked JLCPCB/PCBWay handoff tooling and bounded electrical simulation. Validation: nine unit tests and an export against the frozen fabrication snapshot pass.
2026-11-08 feat(hardware): freeze ordered PGA2350 carrier Rev A
    Add the reviewed 90 x 75 mm two-layer carrier, module footprints, mounting holes, assembly guidance and consolidated parts sourcing. Preserve the exact OSH Park manufacturing ZIP and release hashes.
    Validation: 30 carrier tests pass; source matches the reviewed zero-finding ERC/DRC snapshot, and the released ZIP integrity and board hashes are verified. PGA2350 firmware port and assembled-board bring-up remain pending.
